jail487/Calligraphy-arm-Firmware/Firmware/doghead_arm/image.png

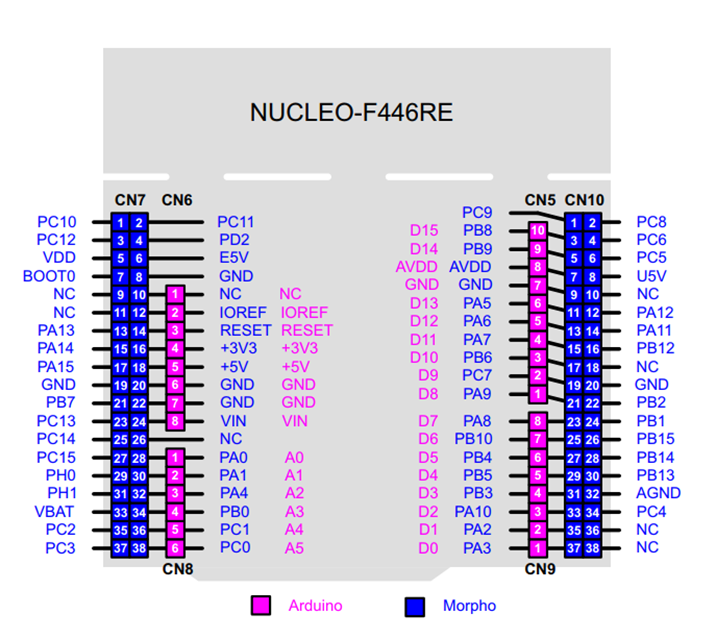
Firmware/doghead_arm/image.png
