jail487/Calligraphy-arm-Firmware/docs/project_management/calligraphy_yong_progress_summary.md

# 機械臂書法「永」字書寫優化進度與成果紀錄

本文件記錄 3-DOF 狗頭機械臂（Doghead Arm）進行毛筆書法「永」字實體書寫的優化歷程，對比去年初期版本與目前最新版本的改善成果。

---

## 一、 成果對比總覽

| 評估項目 | 初期版本（去年剛開始） | 目前最新版本（現況） | 關鍵技術改善手段 |
| :--- | :--- | :--- | :--- |
| **筆劃邊緣平滑度** | 嚴重鋸齒狀、線條起伏顫抖、斷續感明顯 | **圓潤流暢、零鋸齒**，筆劃平滑連貫 | 50Hz 梯形加減速輪廓規劃 + 分段隔離 Hanning 濾波平滑 |
| **文字幾何架構** | 比例變形、傾斜失真、長寬失調 | **端正對稱、骨架穩固**（標準 60×60mm） | 嚴格 3-DOF PPM 逆運動學解算 + 22° 斜面投影長寬幾何補償 |
| **下壓與運筆深度** | 深度不均、偶發浮筆或斷筆 | **墨跡飽滿紮實、筆劃均勻有力** | 實測標定宣紙 3D 平面方程式（傾斜度 4.29cm / 22° 空間補償） |
| **底層控制穩定性** | 經常步進頓挫、指令超時或位置凍結 | **全流程 100% 循跡完成、0 指令拒絕** | STM32 韌體極限角度容差（JOINT_EPS_RAD）+ micro-ROS 握手 |
| **起落筆衔接** | 起落筆過程拖行雜亂 | 各筆劃獨立落筆，起筆無飛墨 | 分段路徑隔離，起落筆原地垂直升降與空中滯空等待 |

---

## 二、 目前具體改善項目細節

### 1. 徹底消除鋸齒與頓挫（Trajectory Smoothing & PVA）
* **問題根源**：初期版本路徑採離散直線硬切，控制頻率不穩定且關節角速度/加速度不連續，導致機械臂劇烈抖動產生鋸齒。
* **改善成果**：
  * 建構 50Hz 固定週期 PVA（位置-速度-加速度）軌跡串流。
  * 採用空間弧長梯形速度規劃與分段隔離平滑，維持 C1 連續性，徹底消除了毛邊與波浪紋。

### 2. 宣紙 3D 傾斜面與幾何形變補償（3D Tilt & Aspect Ratio Compensation）
* **問題根源**：書寫平面並非水平桌面，而是具有約 22° 傾角的斜板，且底座在 45° 待命方向，直接投影會產生嚴重梯形壓縮與形變。
* **改善成果**：
  * 實體標定出紙面空間高度方程式（`z_touch = -12.73cm`, `tilt = 4.29cm`）。
  * 引入長寬比補償（`size_radial = 5.35cm`, `size_tangential = 8.485cm`），使寫在斜面上的字體在正視角下呈現完美的正方形「永」字。

### 3. 下壓深度真實還原（Deep Stroke Realization）
* **問題根源**：過去因為全域濾波把 Z 軸深坑削平，導致下壓感不足、墨色淺淡不一。
* **改善成果**：解除跨段濾波後，下壓量真實發揮（深筆劃達 3.6mm 充分接觸），書法線條粗細變化（提按頓挫）清晰分明。

### 4. 嵌入式韌體與通訊可靠度提升（Firmware & Communication Gate）
* **改善成果**：
  * 解決了底層 STM32 在微動開關歸零極限點（111° / 180°）浮點數微溢位被安全閘拒絕的問題。
  * micro-ROS 25000+ 狀態週期無丢包，書寫全流程 1289 個點 100% 成功執行。

---

## 三、 下一步收尾優化方向（收筆防細拖尾）
* **現存現象**：各筆劃結尾帶有約 2～4mm 朝向正下方的極細拖尾。
* **物理成因**：宣紙斜度（22°）導致世界座標垂直提筆時，在紙面上產生約 45% 的沿坡向下滑動分量。
* **預定措施**：
  1. 下調下壓量至秀麗書法標準（`min_press`: 0.9mm, `max_press`: 2.0mm）。
  2. 提筆時改採「斜面法向量垂直提筆」（Normal Lift），徹底消除下坡滑動拖尾。
