jail487/Calligraphy-arm-Firmware/(list of files, cad)

Other CAD files:
CAD/Base.ipt
CAD/DriveSystem/35R52025_20251226.ipt
CAD/DriveSystem/GAMS_35R42D20G_Sim.ipt
CAD/Link_AB.ipt
CAD/Link_DE.ipt
CAD/Link_ECH.ipt
CAD/Link_FG.ipt
CAD/Link_GH.ipt
CAD/Link_OC.ipt
CAD/Link_OD.ipt
CAD/OldVersions/Base.0002.ipt
CAD/OldVersions/Link_AB.0001.ipt
CAD/OldVersions/Link_DE.0002.ipt
CAD/OldVersions/Link_ECH.0001.ipt
CAD/OldVersions/Link_ECH.0001_1.ipt
CAD/OldVersions/Link_FG.0003.ipt
CAD/OldVersions/Link_GH.0003.ipt
CAD/OldVersions/Link_OC.0004.ipt
CAD/OldVersions/Link_OD.0003.ipt
CAD/OldVersions/PPM_Assembly_20251227.0005.iam
CAD/OldVersions/TriangleLink_CBF.0003.ipt
CAD/PPM_Assembly_20251227.iam
CAD/TriangleLink_CBF.ipt
