jail487/Calligraphy-arm-Firmware/Project_Roadmap_and_Todo.md

# DogHead 書法機械手臂 - 專案開發路徑與待辦事項 (Roadmap & Todo)

**版本**: v1.1  
**最後更新**: 2026-01-06  
**狀態**: 韌體完成 / 軟體開發中

---

## 📌 當前狀態更新 (2026-01-06)

### ✅ 已完成項目

#### 韌體開發 (STM32)
- ✅ FreeRTOS 雙任務架構 (ControlTask 1kHz + CommTask 50Hz)
- ✅ TIM6 硬體中斷觸發精確控制
- ✅ 雙馬達驅動（頻率控制 + PWM 控制）
- ✅ 編碼器回饋（TIM1/TIM4）
- ✅ PID 控制 + 速度/加速度前饋
- ✅ 模式切換系統（PID / 固定速度 / 線性加速 / 階梯加速）
- ✅ micro-ROS 整合（Publisher + Subscriber）
  - `/joint_states` 發布 @ 50Hz
  - `/motor_cmd` 訂閱
  - 完整錯誤處理與重連機制

#### ROS2 軟體架構
- ✅ doghead_control 包（控制節點 + 測試節點）
- ✅ doghead_interfaces 包（服務 + 動作介面）
- ✅ 運動學節點（五連桿 FK/IK 服務）
- ✅ Docker micro-ROS Agent 環境
- ✅ 完整測試框架和文檔

### 🔄 等待硬體階段

**由於目前沒有 STM32 板子，暫時無法進行：**
- ⏸️ 韌體編譯與燒錄
- ⏸️ micro-ROS Agent 連接測試
- ⏸️ 端到端通訊驗證
- ⏸️ 實機 PID 參數調優

### 🚀 當前開發重點：軟體模組（無需硬體）

**Phase 2: ROS2 軟體開發**
- ✅ 運動學計算節點
- ⏳ 軌跡規劃器（進行中）
- ⏳ Action Server（排程中）
- ⏳ 書法軌跡生成（排程中）
- ⏳ Rviz 視覺化（排程中）

---

## 1. 韌體開發階段：FreeRTOS 遷移與馬達控制驗證 ✅ 
*目標：確保底層控制在 RTOS 架構下穩定運行，並具備高性能的運動控制能力。*

### Phase 1.1: 基礎驅動與 RTOS 整合驗證 ✅
- [x] **RTOS 任務運行測試**: `ControlTask` (1kHz) 與 `CommTask` (50Hz) 準時觸發。
- [x] **編碼器讀取測試**: TIM1/TIM4 編碼器數值讀取正確。
- [x] **PWM/頻率輸出測試**: 
    - 13-Pin 馬達的頻率生成 (TIM2) 正常。
    - 8-Pin 馬達的 PWM 佔空比 (TIM3 @ 20kHz) 正確。
- [x] **基本轉速閉環**: P 控制驗證通過，馬達穩定維持設定轉速。

### Phase 1.2: 進階控制算法驗證 (PID + 前饋) ✅
- [x] **控制迴圈時序驗證**: TIM6 硬體中斷確保 1ms 精確觸發。
- [x] **前饋控制實作**: 速度前饋 (Kv) 與加速度前饋 (Ka) 已實作並驗證。
- [x] **軌跡規劃器測試**: 輸入階躍訊號，規劃器輸出平滑曲線。

### Phase 1.3: 參數調優與評估工具整合 ⏸️
- [x] **數據採集功能**: micro-ROS 高速回傳 `/joint_states` (50Hz)。
- [ ] **Python 評估工具升級**: 
    - 修改 `pid_analysis.py` 以適應新的數據格式（需實機數據）。
    - 新增「頻域分析」功能（需實機數據）。
- [ ] **實機調參**: 等待硬體到手後進行。

### Phase 1.4: 運動學與座標控制 ⏸️
- [x] **正逆運動學驗證**: 在 ROS2 軟體端完成（kinematics_node）。
- [ ] **笛卡爾空間控制**: `MoveTo(x, y)` 函式（等待硬體）。
- [ ] **工作空間限制**: 虛擬圍籬驗證（等待硬體）。

---

## 2. 軟體開發階段：書法引擎與 ROS 2 模擬 🔄
*目標：從「輸入文字」到「生成書法軌跡」，並在虛擬環境中驗證。*

### Phase 2.1: 機器人模擬環境 ⏳
*這部分可以在沒有硬體的情況下開發運動學與上層軟體。*
- [ ] **URDF 模型建立**: 
    - 定義五連桿機構的幾何尺寸 (Link lengths)。
    - 設定關節限制 (Joint limits)。
- [ ] **Gazebo/Rviz 模擬**:
    - 在 Rviz 中顯示機器人模型。
    - 使用 `ros2_control` 與 `joint_state_publisher_gui` 測試虛擬手臂移動。
- [x] **運動學驗證**: 運動學節點已在 ROS2 中實作並測試通過。

### Phase 2.2: 書法軌跡生成引擎 (核心演算法)
*書法不僅是路徑，還包含筆觸的「提按」(Z軸) 與「運筆速度」。*
- [ ] **字體解析 (Font Parsing)**:
    - 使用 Python (`freetype` 或 `matplotlib`) 讀取楷書字體 (如 `KaiTi.ttf`)。
    - 提取文字的向量輪廓 (Outlines)。
- [ ] **筆畫提取 (Stroke Extraction)**:
    - **難點**: 單純輪廓無法寫出書法，需要提取「骨架 (Skeleton)」或「中心線」。
    - 實作或使用現有庫 (如 `skimage.morphology.skeletonize`) 取得筆畫路徑。
- [ ] **筆順排序 (Stroke Ordering)**:
    - 確保筆畫順序正確 (由上而下、由左而右)。
- [ ] **書法動態模擬 (Calligraphy Dynamics)**:
    - **Z軸控制 (提按)**: 根據筆畫粗細 (Stroke Width) 計算 Z 軸高度 (壓筆越深，線條越粗)。
    - **速度規劃**: 起筆與收筆慢、行筆快 (模擬真實揮毫的動量)。
    - **旋轉角 (Rotation)**: (若硬體支援) 計算筆桿傾斜角度。

### Phase 2.3: 使用者介面 (UI)
- [ ] **Web UI 或 PyQt 介面**:
    - 輸入框：輸入文字或句子。
    - 預覽區：顯示生成的軌跡路徑。
    - 控制區：發送指令給 ROS 2。

---

## 3. 軟硬體整合階段：micro-ROS 通訊
*目標：連接大腦 (PC/ROS 2) 與小腦 (STM32/FreeRTOS)。*

### Phase 3.1: 通訊架構建立
- [ ] **Docker 環境建置**: 建立包含 ROS 2 Humble + micro-ROS Agent 的 Docker Image，確保開發環境一致。
- [ ] **micro-ROS Agent**: 在 PC 端運行 Agent，透過 UART 連接 STM32。

### Phase 3.2: 訊息定義與實作
- [ ] **Topic: `/joint_states` (STM32 -> PC)**:
    - 頻率: 50Hz ~ 100Hz。
    - 內容: 回傳目前關節角度、速度，供 Rviz 視覺化與紀錄。
- [ ] **Topic: `/cmd_vel` 或 `/motor_cmd` (PC -> STM32)**:
    - 測試階段用，直接控制轉速。
- [ ] **Service: `/set_target_pose` (PC -> STM32)**:
    - 發送目標座標 (X, Y, Z)，請求手臂移動。
- [ ] **Action: `/write_character` (PC -> STM32)**:
    - 發送一連串軌跡點 (Trajectory)，讓手臂執行完整的寫字動作。

---

## 4. 系統整合與最終驗證
- [ ] **全系統聯調**: UI 輸入文字 -> ROS 2 生成軌跡 -> micro-ROS 傳輸 -> STM32 執行控制 -> 馬達驅動。
- [ ] **寫字測試**:
    - 測試基本圖形 (圓、方)。
    - 測試簡單漢字 (一、十、大)。
    - 測試複雜漢字 (永字八法)。
- [ ] **性能優化**: 針對寫字過程中的抖動或延遲進行優化。

---

## 補充：書法機械手臂的特殊需求評估

### 關於自由度 (DOF) 的確認
目前的五連桿機構是 **平面 2-DOF (X, Y)**。要寫出有靈魂的書法，通常需要：
1.  **Z 軸 (抬筆/壓筆)**: **必要**。控制筆與紙的接觸深度來改變線條粗細。
    *   *建議*: 若機構尚未設計 Z 軸，需在末端執行器增加一個伺服馬達 (Servo) 或音圈馬達 (Voice Coil) 來控制筆的升降。
2.  **旋轉軸 (筆桿角度)**: *選配*。模擬側鋒運筆，但對於初階書法機器人，使用圓錐形毛筆配合垂直 Z 軸升降通常已足夠。

### 關於模擬 (Simulation)
**強烈建議在機構完成前進行模擬。**
- **優點**: 
    1. 驗證逆運動學 (IK) 是否有奇異點 (Singularity)。
    2. 確認工作空間 (Workspace) 是否足夠寫出完整的字。
    3. 提早開發軟體，等硬體一好直接整合。
- **工具**: ROS 2 的 `urdf` (模型描述) + `gazebo` (物理模擬) 是標準做法。
