jail487/Calligraphy-arm-Firmware/docs/project_management/agent_worklog.md

# 雙代理工作日誌

> **目前摘要（T30）：** Phase 0–2 的輸出關閉 HIL 已通過。ROS 2 Humble 的乾淨建置通過 5 個套件／31 個測試結果；並已在 NUCLEO-F446RE 驗證 session 綁定與 Agent 重連後舊命令失效。Antigravity 額度用盡後，使用者已授權由 Codex 直接修改原始碼。

這份文件是運動控制與 HIL 執行計畫的精簡監督紀錄。它保存決策與可獨立核對的證據，不重複貼上完整終端機輸出或對話逐字稿。

## 2026-07-31 — T07 韌體建置整合

- **工作切片：** T07；將運動控制原始檔納入 STM32CubeIDE 的 Debug 建置中繼資料與連結輸入。
- **執行狀態：** Antigravity 已完成實作。
- **工作對話識別碼：** `26987c1e-98ff-41bd-9a78-e9225d0402b5`。
- **資源使用：**
  - Codex：此工作流未提供可讀取的數值。
  - Antigravity：`gemini-3.6-flash-medium`；輸入 144,861、輸出 17,400、推理 10,918、快取讀取 966,036、回報總計 162,261。
  - 重試次數：0；工作回合：1。
- **回報變更範圍：** Debug `subdir.mk` 與 `objects.list`，加入 `joint_units`、`motor_parameters` 的原始檔與物件檔。
- **監督結論：** 工作者結果可取得；在標記為已驗證前，仍須獨立審查差異並執行韌體建置。

## 2026-07-31 — T27 session 安全交接與 HIL

- **工作切片：** 建立 `McuSessionControl`、主機端 session epoch、MCU 可靠訂閱與失效即關閉（fail-closed）行為。
- **已驗證證據：** 合法 session／序號命令可接受；錯誤 session、過時序號、版本不符與 TTL 過期均被拒絕；解除武裝及 Agent 重啟後，先前命令不再有效。
- **安全狀態：** `enable_mask = 0`，沒有啟用馬達輸出。
- **後續條件：** 帶電馬達 Phase 3 仍需要硬體規格、緊急停止機制與另外的明確授權。

## 後續紀錄格式

每一個持續中的工作切片只追加下列欄位：

- **工作切片／時間**
- **狀態：** 已開始、輪詢中、審查中、重試、已驗證、下一切片或真正阻塞。
- **證據：** 指令與結果摘要，或結果檔案狀態。
- **資源使用：** 可取得時記錄 Codex 數值，以及 Antigravity 的模型、輸入／輸出／推理／快取讀取／回報總計與重試次數。
- **決策／下一步。**
