jail487/Calligraphy-arm-Firmware/Firmware/doghead_arm/Core/Src/main.c

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
/* Includes ------------------------------------------------------------------*/
#include "main.h"
#include "cmsis_os.h"

/* USER CODE BEGIN Includes */
#include "mainpp.h"
#include "robot_config.h"
#include "hardware_io.h"
//#include <rcl/rcl.h>
//#include <rcl/error_handling.h>
//#include <rclc/rclc.h>
//#include <rclc/executor.h>
//#include <uxr/client/transport.h>
//#include <rmw_microxrcedds_c/config.h>
//#include <rmw_microros/rmw_microros.h>
/* USER CODE END Includes */

TIM_HandleTypeDef htim1;
TIM_HandleTypeDef htim2;
TIM_HandleTypeDef htim3;
TIM_HandleTypeDef htim4;
TIM_HandleTypeDef htim5;
TIM_HandleTypeDef htim6;
TIM_HandleTypeDef htim8;
TIM_HandleTypeDef htim12;
TIM_HandleTypeDef htim13;

UART_HandleTypeDef huart2;
DMA_HandleTypeDef hdma_usart2_rx;
DMA_HandleTypeDef hdma_usart2_tx;

/* Definitions for defaultTask */
osThreadId_t defaultTaskHandle;
const osThreadAttr_t defaultTask_attributes = {
  .name = "defaultTask",
  .stack_size = 512 * 4,
  .priority = (osPriority_t) osPriorityNormal,
};
/* USER CODE BEGIN PV */
// 所有的控制變數已經移動到 robot_arm_core.cpp 與 mainpp.h

// [Task Handle] 控制任務句柄（供 TIM6 中斷使用）
TaskHandle_t xControlTaskHandle = NULL;
/* USER CODE END PV */

void SystemClock_Config(void);
static void MX_GPIO_Init(void);
static void MX_DMA_Init(void);
static void MX_USART2_UART_Init(void);
static void MX_TIM1_Init(void);
static void MX_TIM2_Init(void);
static void MX_TIM3_Init(void);
static void MX_TIM4_Init(void);
static void MX_TIM6_Init(void);
static void MX_TIM5_Init(void);
static void MX_TIM8_Init(void);
static void MX_TIM12_Init(void);
static void MX_TIM13_Init(void);
void StartDefaultTask(void *argument);

/* USER CODE BEGIN PFP */
#include "nidec_motor_driver.h"
void MX_FREERTOS_Init(void);
/* USER CODE END PFP */

/* USER CODE BEGIN 0 */
#include "runtime_monitor.h"
/* USER CODE END 0 */

/**
  * @brief  The application entry point.
  * @retval int
  */
int main(void)
{

  /* MCU Configuration--------------------------------------------------------*/

  /* Reset of all peripherals, Initializes the Flash interface and the Systick. */
																																				  HAL_Init();

  /* Configure the system clock */
  SystemClock_Config();

  /* USER CODE BEGIN SysInit */
  RuntimeMonitor_Init();
  /* USER CODE END SysInit */

  /* Initialize all configured peripherals */
  MX_GPIO_Init();
  MX_DMA_Init();
  MX_USART2_UART_Init();
  MX_TIM1_Init();
  MX_TIM2_Init();
  MX_TIM3_Init();
  MX_TIM4_Init();
  MX_TIM6_Init();
  MX_TIM5_Init();
  MX_TIM8_Init();
  MX_TIM12_Init();
  MX_TIM13_Init();
  /* USER CODE BEGIN 2 */
    Robot_Init();
    // 模式切換統一使用 test_mode_selection 變數控制
  /* USER CODE END 2 */

  /* Init scheduler */
  osKernelInitialize();

  /* USER CODE BEGIN RTOS_MUTEX */
  /* add mutexes, ... */
  /* USER CODE END RTOS_MUTEX */

  /* USER CODE BEGIN RTOS_SEMAPHORES */
  /* add semaphores, ... */
  /* USER CODE END RTOS_SEMAPHORES */

  /* USER CODE BEGIN RTOS_TIMERS */
  /* start timers, add new ones, ... */
  /* USER CODE END RTOS_TIMERS */

  /* USER CODE BEGIN RTOS_QUEUES */
  /* add queues, ... */
  /* USER CODE END RTOS_QUEUES */

  /* Create the thread(s) */
  /* creation of defaultTask */
  defaultTaskHandle = osThreadNew(StartDefaultTask, NULL, &defaultTask_attributes);
  if (defaultTaskHandle == NULL) {
    Error_Handler();
  }

  /* USER CODE BEGIN RTOS_THREADS */
  /* add threads, ... */
  MX_FREERTOS_Init();  // 建立自訂的控制任務和通訊任務
  /* USER CODE END RTOS_THREADS */

  /* USER CODE BEGIN RTOS_EVENTS */
  /* add events, ... */
  /* USER CODE END RTOS_EVENTS */

  /* Start scheduler */
  osKernelStart();

  /* We should never get here as control is now taken by the scheduler */

  /* Infinite loop */
  /* USER CODE BEGIN WHILE */
  while (1)
  {
    /* USER CODE END WHILE */

    /* USER CODE BEGIN 3 */
    // 注意: FreeRTOS 啟動後 (osKernelStart) 不會執行這裡
    // 所有控制邏輯應放在 FreeRTOS 任務中
  }
  /* USER CODE END 3 */
}

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
/* USER CODE BEGIN 4 */
int __io_putchar(int ch)
{
  HAL_UART_Transmit(&huart2, (uint8_t *)&ch, 1, HAL_MAX_DELAY);
  return ch;
}
/**
  * Enable DMA controller clock
  */
static void MX_DMA_Init(void)
{
  /* DMA controller clock enable */
  __HAL_RCC_DMA1_CLK_ENABLE();

  /* DMA interrupt init */
  /* DMA1_Stream5_IRQn interrupt configuration */
  HAL_NVIC_SetPriority(DMA1_Stream5_IRQn, 6, 0);
  HAL_NVIC_EnableIRQ(DMA1_Stream5_IRQn);
  /* DMA1_Stream6_IRQn interrupt configuration */
  HAL_NVIC_SetPriority(DMA1_Stream6_IRQn, 6, 0);
  HAL_NVIC_EnableIRQ(DMA1_Stream6_IRQn);
}

void HAL_GPIO_EXTI_Callback(uint16_t GPIO_Pin)
{
  HW_OnExtInterrupt(GPIO_Pin);
}

/* USER CODE END 4 */

/* USER CODE BEGIN Header_StartDefaultTask */
/**
  * @brief  Function implementing the defaultTask thread.
  * @param  argument: Not used
  * @retval None
  */
/* USER CODE END Header_StartDefaultTask */
void StartDefaultTask(void *argument)
{
  /* USER CODE BEGIN 5 */
  /* Infinite loop */
  for(;;)
  {
    osDelay(1000);
  }
  /* USER CODE END 5 */
}

/**
  * @brief  Period elapsed callback in non blocking mode
  * @note   This function is called  when TIM7 interrupt took place, inside
  * HAL_TIM_IRQHandler(). It makes a direct call to HAL_IncTick() to increment
  * a global variable "uwTick" used as application time base.
  * @param  htim : TIM handle
  * @retval None
  */
void HAL_TIM_PeriodElapsedCallback(TIM_HandleTypeDef *htim)
{
  if (htim->Instance == TIM7)
  {
    HAL_IncTick();
  }
  /* USER CODE BEGIN Callback 1 */
  // 合併來自 stm32f4xx_it.c 的 TIM6 處理邏輯
  if (htim->Instance == TIM6) {
    BaseType_t xHigherPriorityTaskWoken = pdFALSE;
    
    // 發送通知到控制任務（從中斷安全版本）
    if (xControlTaskHandle != NULL) {
      vTaskNotifyGiveFromISR(xControlTaskHandle, &xHigherPriorityTaskWoken);
    }
    
    // 如果喚醒了更高優先級任務，請求上下文切換
    portYIELD_FROM_ISR(xHigherPriorityTaskWoken);
  }
  /* USER CODE END Callback 1 */
}

/**
  * @brief  This function is executed in case of error occurrence.
  * @retval None
  */
void Error_Handler(void)
{
  /* USER CODE BEGIN Error_Handler_Debug */
  /* User can add his own implementation to report the HAL error return state */
  __disable_irq();
  while (1)
  {
  }
  /* USER CODE END Error_Handler_Debug */
}

#ifdef  USE_FULL_ASSERT
/**
  * @brief  Reports the name of the source file and the source line number
  *         where the assert_param error has occurred.
  * @param  file: pointer to the source file name
  * @param  line: assert_param error line source number
  * @retval None
  */
void assert_failed(uint8_t *file, uint32_t line)
{
  /* USER CODE BEGIN 6 */
  /* User can add his own implementation to report the file name and line number,
     ex: printf("Wrong parameters value: file %s on line %d\r\n", file, line) */
  /* USER CODE END 6 */
}
#endif /* USE_FULL_ASSERT */
