jail487/Calligraphy-arm-Firmware/(commit log)

2026-07-27 refactor: Decouple motor pin configuration into Application/motor_config, restore M1/M3 motor mapping, and update homing speeds
2026-07-28 refactor(firmware): decouple application layer and freertos middleware
    - Extracted safety state machine into safety_manager.cpp
    - Refactored homing logic into homing_calibration.cpp with Robot_Homing_Tick
    - Migrated test scenarios into test_scenarios.cpp
    - Simplified FreeRTOS ControlTask to call Robot_ControlTask_Tick
    - Consolidated robot state and target variables into RobotState_t and RobotTarget_t
    - Updated gitignore to exclude build artifacts and IDE metadata
2026-10-29 chore(kinematics): update link lengths R1=R2=140mm and tool forward offset=45.3mm
