jail487/Calligraphy-arm-Firmware/(notices)

Notices in the files:
Firmware/doghead_arm/Core/Src/main.c:
Copyright (c) 2025 STMicroelectronics.
All rights reserved.
This software is licensed under terms that can be found in the LICENSE file
